Emilien-Wolff/Pronto-Abysse/README.md

# Pronto - projet de l'ingénieur dans un monde en transition ⚙️
> [!NOTE]
> Un projet dans le cadre de notre première année en école d'ingénieur visant la conception et fabrication complète d'un drone sous-marin radicommandé



## Objectifs

> Piloter le sous marin à distance et le contrôler (profondeur et déplacement) de manière précise et sans fils

> Transmettre une vidéo en direct à l'utilisateur. Nous prévoyons donc une bascule entre deux flux vidéo : l'un vers l'avant pour le pilotage et l'autre vers le fond pour l'observation

## Points abordés

 - Gestion de projet : diagramme de Gantt, partage des tâches et planification tout au long du projet
 - Invention et construction de A à Z une structure interne modulaire qui a montré son efficacité lors de
multiples assemblages et désassemblages lors des tests
 - Un dimensionnement global équilibré permettant le transport tout en embarquant l’ensemble de
l’électronique nécessaire à son maniement
 -  Des concepts inédits de dérive fonctionnels et pilotables par télécommande radio
 -  Une chaine de puissance sur mesure, correctement dimensionnée et également pilotable fi nement via la
télécommande
 -  Un asservissement fonctionnel de l’assiette, combiné à un controle de la fl ottabilité via des ballastsà
base de seringues
 -  Un prééquipement de fi xation pour les caméras, dirigées vers l’avant et vers le fond et une prévision
d’éclairage par leds puissantes à travers le tube transparent
 -  Une communication tout au long du projet

## FAQ

#### Vous avez pu choisir votre sujet ?
OUI, Pronto est une unité d'enseignement qui fait partie de la formation d'ingénieur à IMT Atlantique, et 3 sujet différents étaient possibles : le sujet ingénieur, le sujet recherche et finalement le sujet étudiant. C'est pour le dernier que nous avons opté. Nous avons donc pu choisir l'équipe et le sujet. En lien avec le contexte géographique de l'école, il nous semblait parfait.

#### Combien de temps ça vous a pris ?

Le projet a duré 5 mois, de janvier 2025 à  mi mai 2025

## 🚀 Qui sommes-nous ?
Nous sommes actuellement en première année d'école d'ingénieur à l'école des Mines IMT Atlantique.
