Emilien-Wolff/Pronto-Abysse/CAO/Readme.md

# Conception assistée par ordinateur

Ce dossier contient les fichiers de conception du sous-marin, réalisés avec Fusion 360.

## Contenu du dossier

- **Fichier `.f3z`** : Assemblages natifs de Fusion 360, permettant de modifier les composants individuellement. La conception est entièrement faite à la main, et des sections d'analyse (vue de coupe) sont intégrées au modèle

## Utilisation

- **Fusion 360** : Importez les fichiers `.f3z` pour modifier les composants du boîtier.

📁 *Assurez-vous d'extraire tous les fichiers associés avant d'ouvrir un assemblage dans Fusion 360.*
