Emilien-Wolff/Pronto-Abysse/STL à imprimer/Readme.md

# STL à imprimer

Ce dossier contient les fichiers STL des composants du sous-marin, réalisés avec Fusion 360 et entièrement dessinés à la main

## Contenu du dossier

- **Fichiers `.stl`** : pièces modélisées, qui peuvent s'ouvrir dans n'importe quel trancheur pour impression

📁 *Les impressions 3D ont toutes été faites en PLA, avec un remplissage variant en fonction de l'utilité des pièces. Les murs ont notamment été renforcés pour plus de durabilité.*

---

Impression 3D en PLA sur P1S, 0,2mm d'épaisseur de couche, avec supports, avec du filament bambulab mat
