Emilien-Wolff/Pronto-Abysse/Suivi de projet/Readme.md

# Suivi de projet

Voici un dossier qui contient les livrables des différents jalons projet

## Fichiers Inclus

- **83_cadrage_PRONTO_25.pdf :** Définissant notre besoin, notre analyse des solutions technique, le cahier des charges et la solution technique proposée
- **83_revue_PRONTO_25.pdf :** Présentation de l'avancée de mi projet en avril 2025

## Licence

Ce projet est libre d'accès
