Emilien-Wolff/Pronto-Abysse/83_recette_finale_PRONTO_25_compressed.pdf

### Recette - Projet Abysse

Tuteur : F. Le Pennec

Auteurs : E. Wolff (relecteur), A. Polette, P. Gonot, S. Khazari, G. Pauliat
Destinataires : F. Le Pennec, B. Abiven, M. Le Gall, J. Hemery

Groupe 83 Pronto
version 1.0
IMT Atlantique
23/05/25

SOMMAIRE
1. Présentation du projet et des objectifs
2. Conception
3. Réalisation et tests unitaires
4. Intégration et tests
5. Communication : site internet

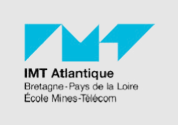
[picture p76: figure]

6. Perspectives d’amélioration
7. Travail de groupe

3
SOMMAIRE | 3
1. Présentation du projet et des objectifs
2. Conception
3. Réalisation et tests unitaires
4. Intégration et tests
5. Communication : site internet
6. Perspectives d’amélioration
7. Travail de groupe

Recette - Projet Abysse
Groupe 83 Pronto | 23/05/25

Présentation du projet et contextualisation | 4

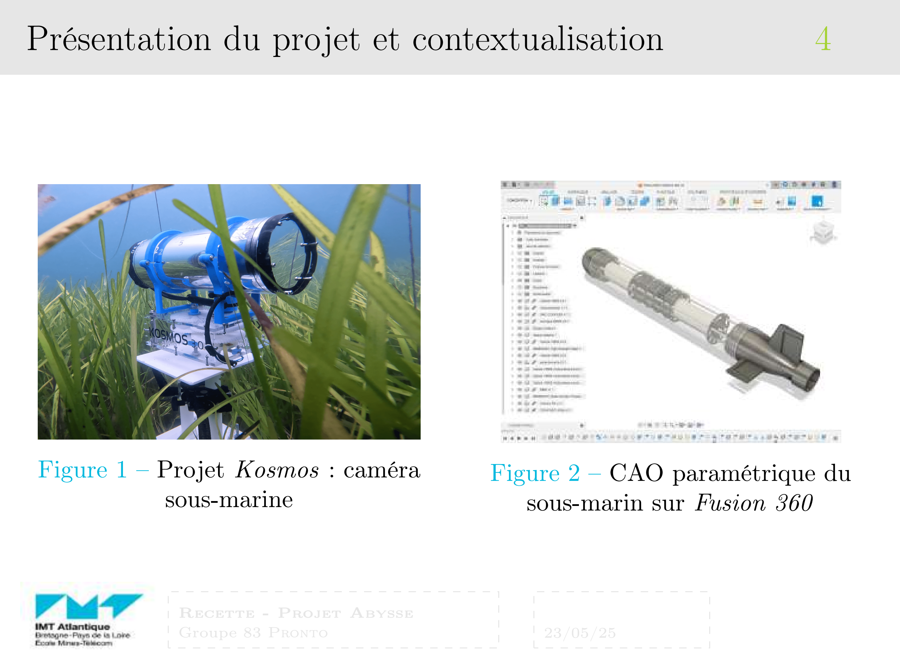
[picture p77: page 4]

4

Figure 1 – Projet Kosmos : caméra sous-marine

Figure 2 – CAO paramétrique du sous-marin sur Fusion 360

Recette - Projet Abysse

5
Présentation des objectifs | 5

Objectifs

1. Piloter le sous-marin à distance et le contrôler (profondeur et déplacement) de manière précise et sans fils
2. Transmettre une vidéo en direct à l’utilisateur. Nous prévoyons donc une bascule entre deux flux vidéo : l’un vers l’avant pour le pilotage et l’autre vers le fond pour l’observation

Recette - Projet Abysse

6
SOMMAIRE | 6
1. Présentation du projet et des objectifs
2. Conception
3. Réalisation et tests unitaires
4. Intégration et tests
5. Communication : site internet
6. Perspectives d’amélioration
7. Travail de groupe

Recette - Projet Abysse

7

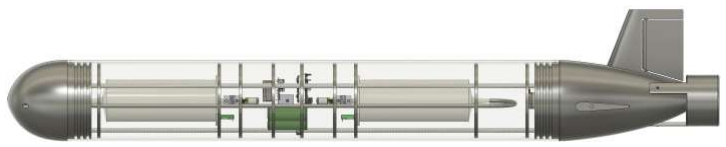
[picture p78: figure]

- Structure modulaire pour développement en parallèle
- Identification des fonctions internes

Recette - Projet Abysse

8
Présentation de la chaîne fonctionnelle | 8

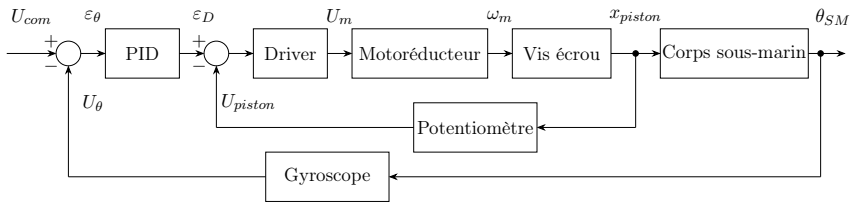
[picture p79: figure]
PID; Driver; Motoréducteur; Vis écrou; Corps sous-marin; Potentiomètre; Gyroscope; Ucom; xpiston; θSM; Upiston

Figure 3 – Schéma bloc de l’asservissement du sous-marin

Recette - Projet Abysse

9

### Dimensionnement général : taille du sous-marin 9

La masse envisageable pour être transportable serait donc d’environ 15 kg .

Limite de la flottabilité ⇒ poids équivalent à son rapport en eau, donc de volume
VSM = 15 · 10⁻³ m³

Notre idée initiale était de partir sur un tube de 128 mm, ce qui nous conduit à une longueur de

ℓSM =

VSM

Stube

=

VSM
πD²/4

=

15 · 10⁻³
π(128 · 10⁻³)
2/4
= | 1, 15 m | (1)

C’est utilisable

Recette - Projet Abysse

10
Dimensionnement général : structure interne | 10

Structure interne qui doit être solide et compartimentée ⇒ disques imprimés en 3D

- Perçages pour les batteries
- Inserts filetés pour fixer les composants
- Trous pour tiges filetées

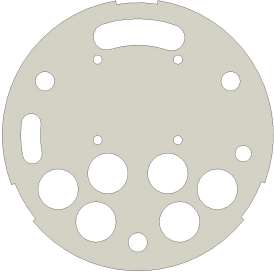
[picture p80: figure]

Figure 4 – Exemple de disque

Recette - Projet Abysse

11
Dimensionnement général : Choix du moteur | 11
Hélice : v = p × ω | (2)

Or choix du moteur selon le paramètre KV, avec p = 1.4 cm .

La vitesse d’avance étant de v = 5 km/h, soit 1, 4 m/s, nous en déduisons que le taux de rotation doit être de

ω =

1, 4
0, 014

= 100 tr/s = 6000 tr/min (3)

+25% ⇒ 7500 tr/min sous 12 V donc
7500/12 = 625 KV. On choisit un | 750 KV | .

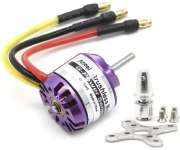
[picture p81: figure]

Figure 5 – Moteur
brushless choisi de
750KV

Recette - Projet Abysse

12
Conception assistée par ordinateur | 12

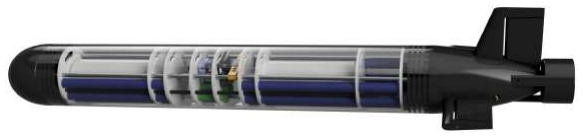
[picture p82: figure]

Figure 6 – Capture du modèle 3D du sous-marin fait sous Fusion 360 (Autodesk)

Pourquoi avoir modélisé en 3D ?

- Placement précis et simulation des liaisons
- Paramétrage → modèle qui se reconstruit
- Exportation pour Blender
- Production de plans 2D et modèles 3D pour tranchage et impression

Recette - Projet Abysse

13
Solution de direction | 13

Pour diriger le sous-marin, 2 solutions :
1. Implanter 4 pompes directrices
2. Utiliser des gouvernails comme dans les vrais sous-marins

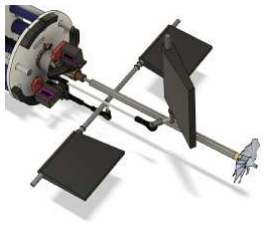
[picture p83: figure]
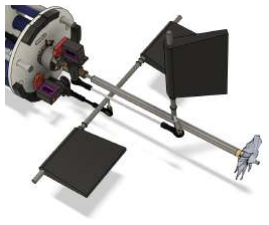
[picture p84: figure]

Figure 7 – Débattement mesurable sur CAO et permi par les servomoteurs

Recette - Projet Abysse

14
Lests et ballasts | 14

Par une étude statique, on récupère le nombre de barres N de lest nécessaires au sous-marin :

N =

(ρf luide · VSM − msans) · 4

ρferπD²L

(4)

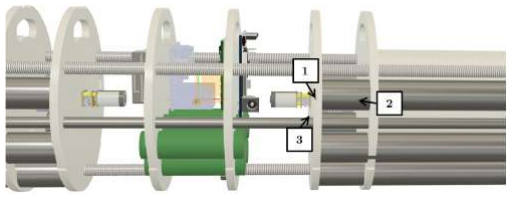
[picture p85: figure]

Figure 8 – Positions des centres de masse

Recette - Projet Abysse

15
Etanchéité | 15

Deux solutions d’étanchéité envisagées dans le projet :

- Des gorges dans l’impression 3D en (A) dans lesquelles se glissent des joints toriques
- Des plus petits joints toriques
en (B) dans lesquels

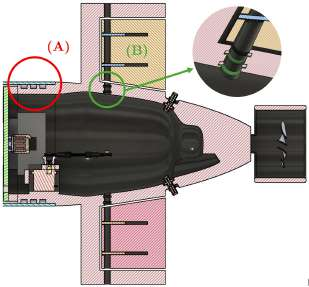
[picture p86: figure]

coulissent les axes | Figure 9 – Solutions de jointage
| dans la CAO

Recette - Projet Abysse

16
Mécanique de l’asservissement des ballasts | 16

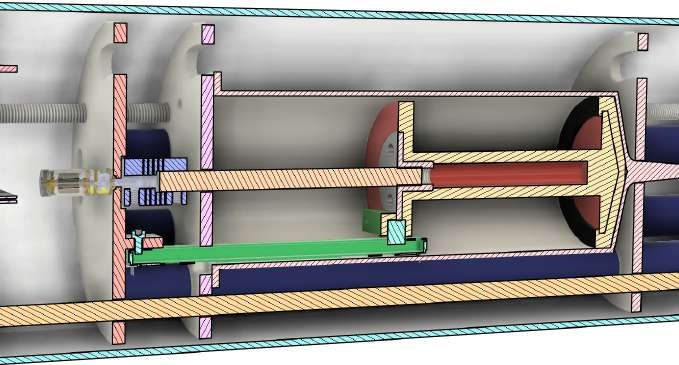
[picture p87: figure]

Figure 10 – Coupe de la partie seringue

Recette - Projet Abysse

17
Alimentation de l’électronique | 17

Figure 11 – Choix des cellules li-ion INR18650 3500 mAh

Dimensionnement de la batterie

- Évaluation du besoin
- tension nominale U ≈ 12 V
- intensité maximale Imax ≈ 16 A
- Réponse au besoin
- tension nominale Ucellule = 3, 7 V
- intensité maximale

Imax,cellule ≈ 10 A

⇒ batterie 3S2P

Recette - Projet Abysse

18
Alimentation de l’électronique | 18

Schéma électrique et choix des bandes conductrices

- Nécessité d’un BMS
- équilibrage des charges des
cellules
- protection de la batterie
- Choix du matériau et de la géométrie
- bandes de nickel
- 8 mm en largeur / 0.4 mm en épaisseur

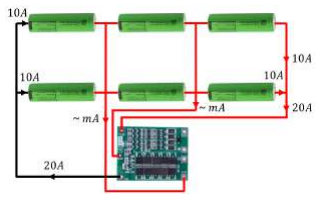
[picture p88: figure]

Figure 12 – Schéma électrique du lien batterie / BMS

Recette - Projet Abysse

Radiocommande | 19

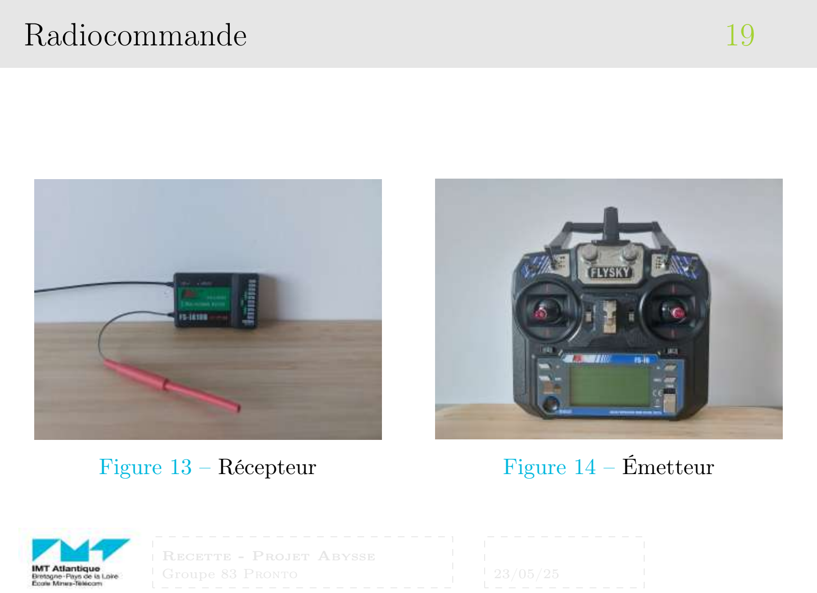
[picture p89: page 19]

19

Figure 13 – Récepteur | Figure 14 – Émetteur

Recette - Projet Abysse

Circuits électriques indépendants | 20

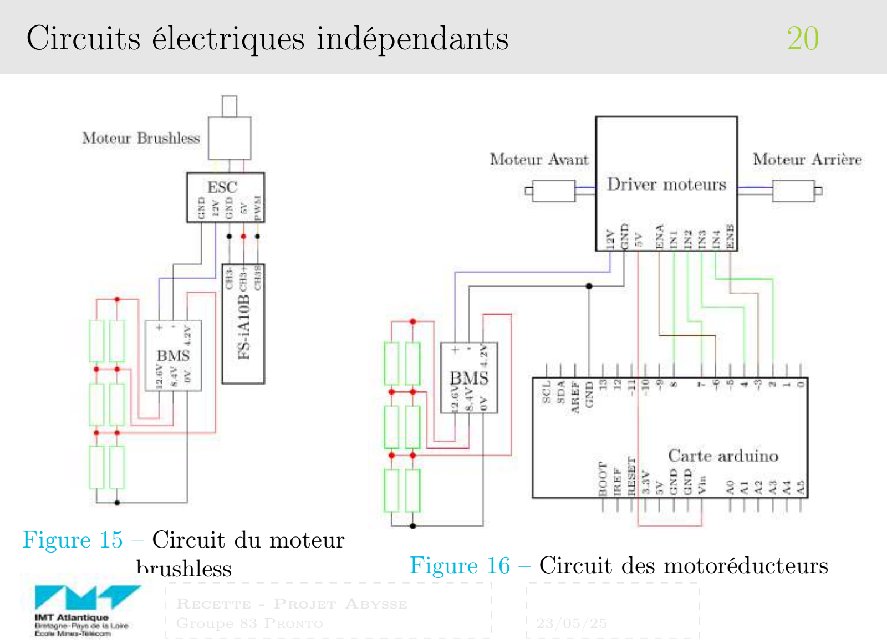
[picture p90: page 20]

20

Figure 15 – Circuit du moteur
brushless | Figure 16 – Circuit des motoréducteurs

Recette - Projet Abysse

21

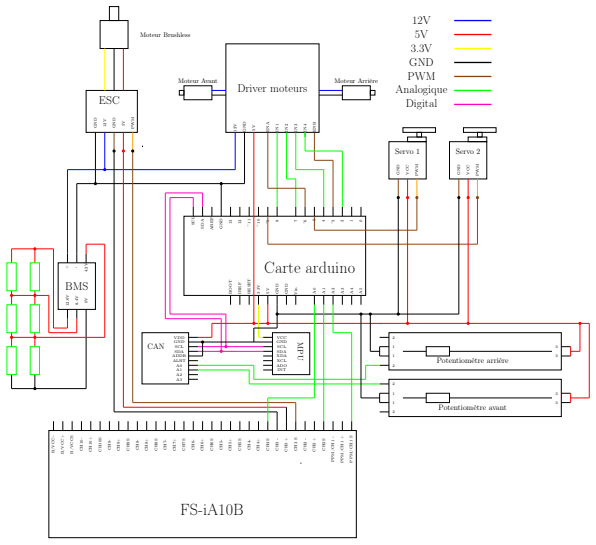
[picture p91: figure]
Driver moteurs; SDA; AREF; GND; SCL; BOOT; IREF; RESET; Vin; ENA; ENB; PPM/CH1 S; PPM/CH1 -; PPM/CH1 +; Servo 1 GND; VCC; Servo 2 GND; PWM; VCC GND; SCL SDA XDA XCL ADO; INT; MPU; Moteur Avant; Moteur Arrière; 12V 5V 3.3V GND; PWM Analogique Digital; 8.4V BMS; Carte arduino CH¹⁰⁻; CH⁹⁻; CH⁹+; CH⁹S; CH⁸⁻; CH⁸+; CH⁸S; CH⁷⁻; CH⁷+; CH⁷S; CH⁶⁻; CH⁶+; CH⁶S; B/VCC-; B/VCC+; B/VCCS; VDD CAN GND SCL SDA ADDR ALRT A0 A1 A2 A3; 3 3 Potentiomètre arrière; 3 3 Potentiomètre avant; Moteur Brushless; ESC

Figure 17 – Circuit électrique complet du sous-marin

Recette - Projet Abysse

22
Structure du code | 22

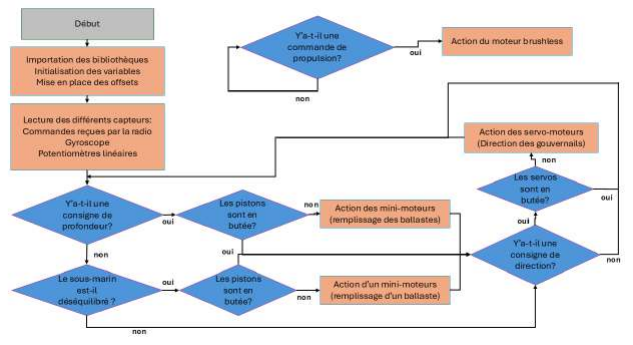
[picture p92: figure]

Figure 18 – Structure du code

Recette - Projet Abysse

23
SOMMAIRE | 23
1. Présentation du projet et des objectifs
2. Conception
3. Réalisation et tests unitaires
4. Intégration et tests
5. Communication : site internet
6. Perspectives d’amélioration
7. Travail de groupe

Recette - Projet Abysse

24
Indépendance des opérations | 24

L’avancée du projet a été permise par la parallélisation des tâches, grâce aux modules du projet :

Montage du sous-marin avec composants | Usinage des pièces mécaniques
CAO complète | Création des circuits électroniques
Phase de cadrage | Commande des pièces

Programmation de l’Arduino et adaptations

Transmission vidéo et RC

t

P1

P2

P2

P2

P2

Figure 19 – Étagement du projet

Recette - Projet Abysse

25
Impression et implantation des disques | 25

Disques imprimés et leur montage :

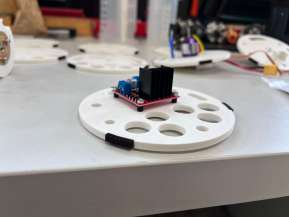
[picture p93: figure]
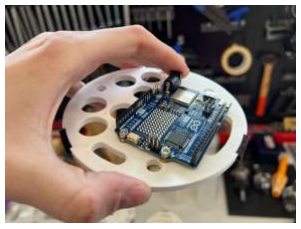
[picture p94: figure]

Figure 20 – Exemple de certains disques (à gauche, celui supportant le contrôleur moteur, éloigné de la surface par des entretoises elles aussi imprimées et à droite, celui tenant l’Arduino)

Recette - Projet Abysse

26
Impression et implantation des ogives | 26

Structure :

- Esthétique : corps
transparent
- Limiter les problèmes
d’étanchéité : augmentation les risques avec le nombre de jonctions

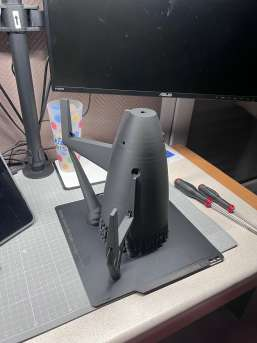
[picture p95: figure]

Figure 21 – Ogive arrière, sortie d’imprimante

Recette - Projet Abysse

27
Réalisation de la batterie | 27

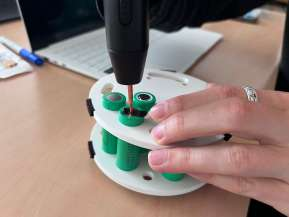
[picture p96: figure]
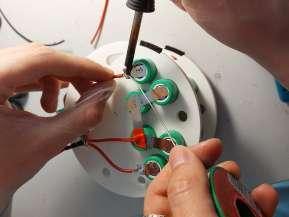
[picture p97: figure]

Figure 22 – Deux techniques de soudage : soudage par point à gauche, soudage classique à droite

Recette - Projet Abysse

Réalisation de la batterie | 28

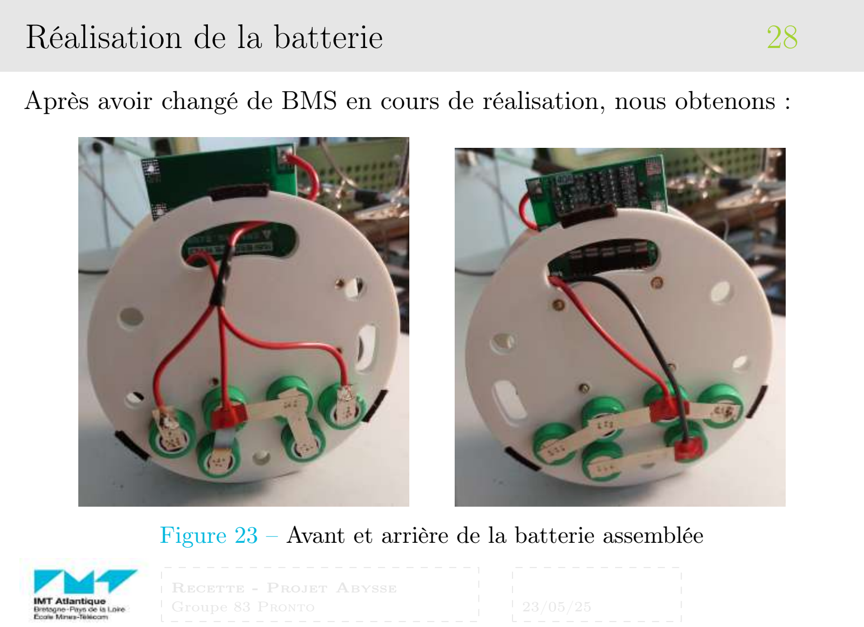
[picture p98: page 28]

28

Après avoir changé de BMS en cours de réalisation, nous obtenons :

Figure 23 – Avant et arrière de la batterie assemblée

Recette - Projet Abysse

29
Usinage des axes | 29

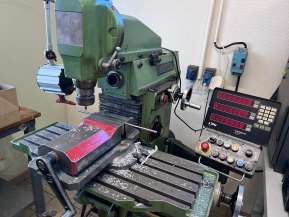
[picture p99: figure]
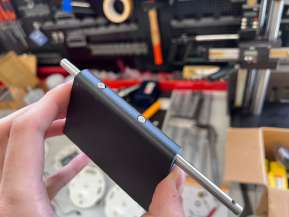
[picture p100: figure]

Figure 24 – Usinage sur fraiseuse des axes et montage sur les gouvernails

Recette - Projet Abysse

30
Tiges de commande | 30

Sont présents :
- les supports des servomoteurs,
intégrés dans la coque intérieur de l’impression 3D et qui
reçoivent des inserts filetés pour y visser une plaque pour empêcher leur mouvement
lorsque l’index tourne
- un des axes qui apparaît horizontalement
- la biellette excentrée qui est actionnée par les servomoteurs démontés pour la photo.

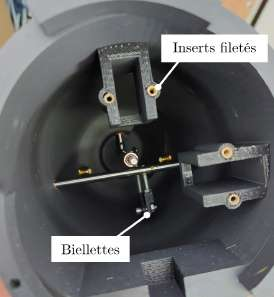
[picture p101: figure]

Figure 25 – Tringlerie de l’ogive arrière

Recette - Projet Abysse

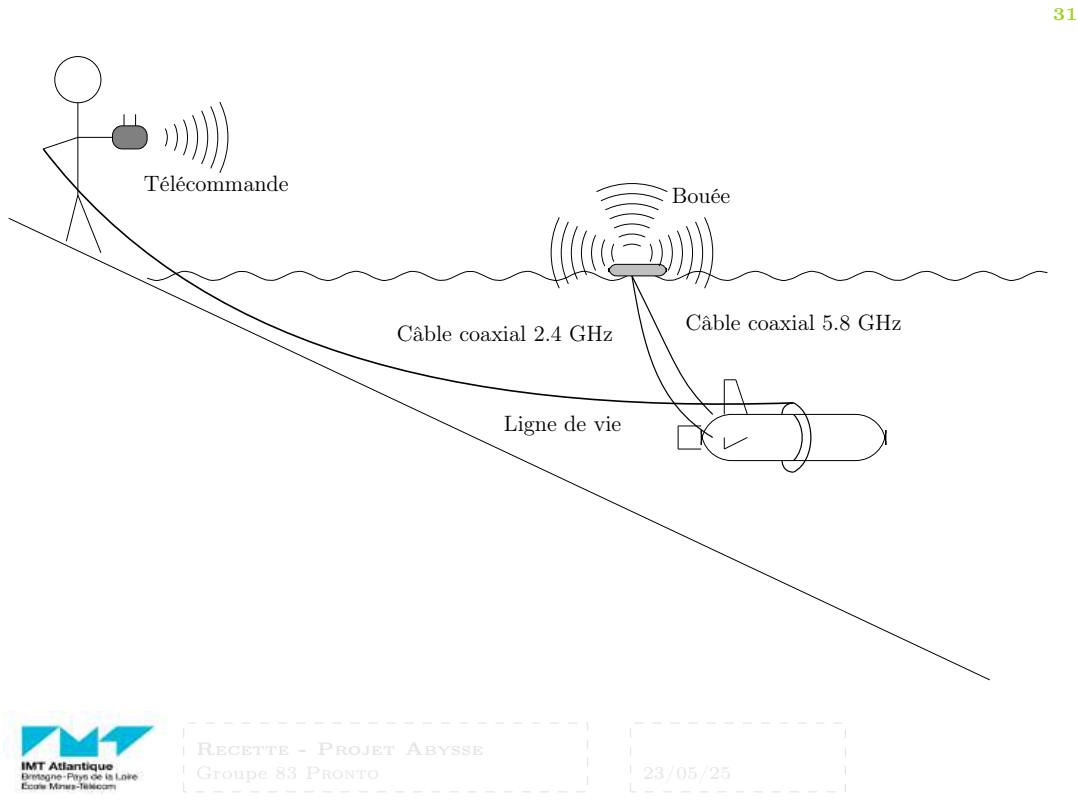
[picture p102: page 31]
Télécommande; Bouée

Câble coaxial 5.8 GHz Câble coaxial 2.4 GHz

Ligne de vie

Recette - Projet Abysse

32
Tests communication | 32

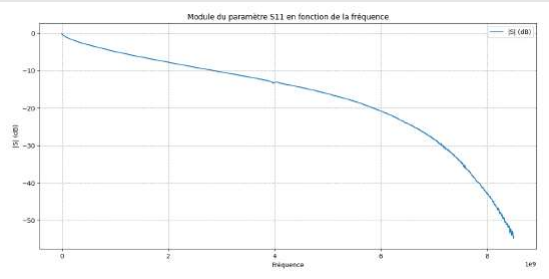
[picture p103: figure]

Figure 26 – Paramètre s12 du câble

Recherche de la meilleure transmission de puissance possible
- Très bonne pour les fonctions de commande
- Moins pour la vidéo

Recette - Projet Abysse

33
Tests communication | 33

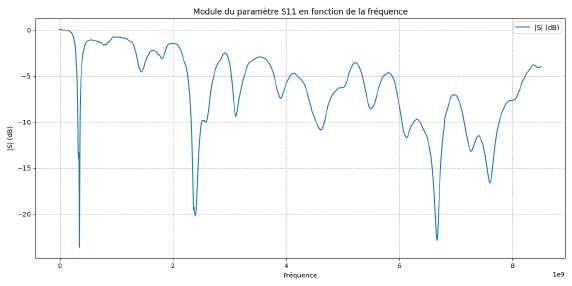
[picture p104: figure]

Figure 27 – Paramètre s11 de l’antenne

- Adaptée au 2.4GHz

Recette - Projet Abysse

34
SOMMAIRE | 34
1. Présentation du projet et des objectifs
2. Conception
3. Réalisation et tests unitaires
4. Intégration et tests
5. Communication : site internet
6. Perspectives d’amélioration
7. Travail de groupe

Recette - Projet Abysse

35
Environnement de travail | 35

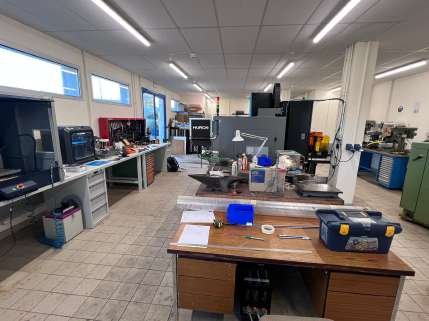
[picture p105: figure]

Figure 28 – Table de montage dans l’atelier mécanique de IMT Atlantique et machine d’usinage

Recette - Projet Abysse

36
Méthodologie de montage | 36

Les étapes de montage du
sous-marin ont été les suivantes :
- Essai dimensionnel de la solution à joints toriques
- Montage unitaire des
composants sur les disques
- Coulissage des disques sur les tiges filetées en respectant les espacements
- Insertion dans le tube et fermeture de l’ensemble

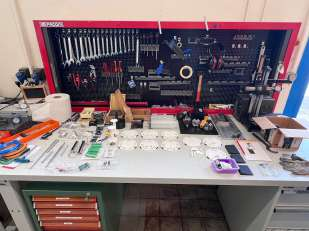
[picture p106: figure]

Figure 29 – Rangement des
composants

Recette - Projet Abysse

### Tests d’étanchéité de l’ensemble : test en piscine 37

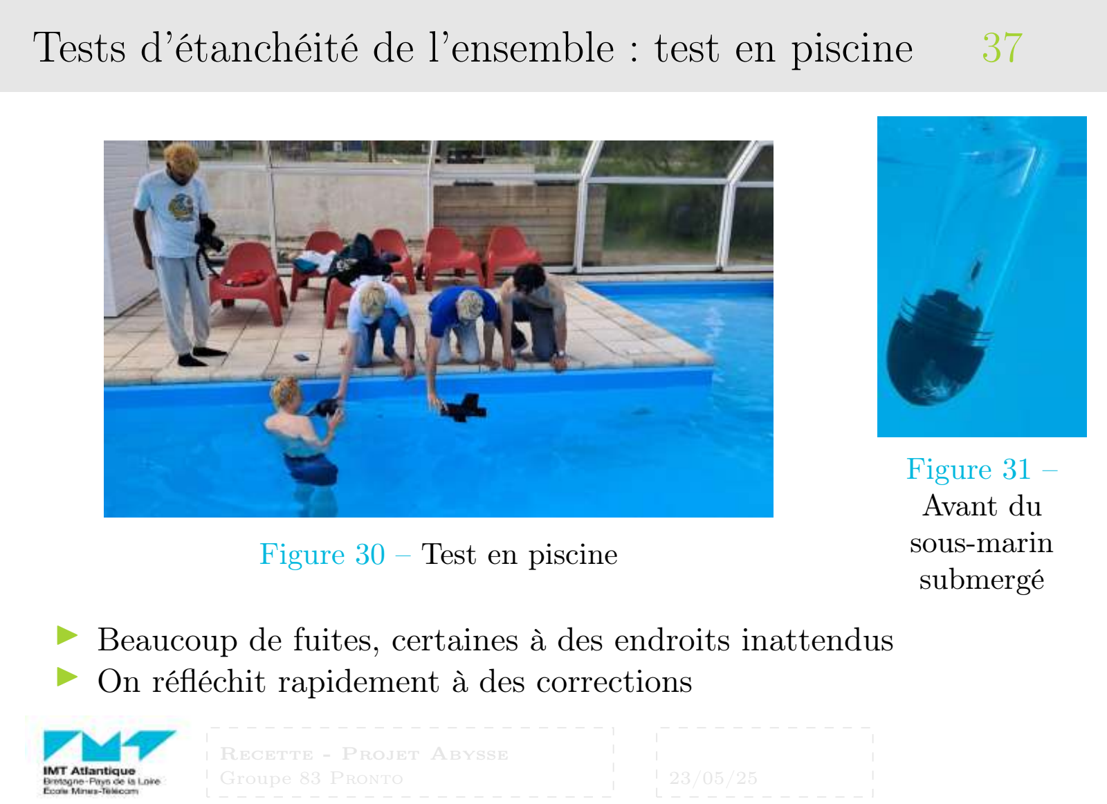
[picture p107: page 37]

37

Figure 30 – Test en piscine

Figure 31 –
Avant du
sous-marin
submergé
- Beaucoup de fuites, certaines à des endroits inattendus
- On réfléchit rapidement à des corrections

Recette - Projet Abysse

Tests d’étanchéité de l’ensemble : test en bac | 38

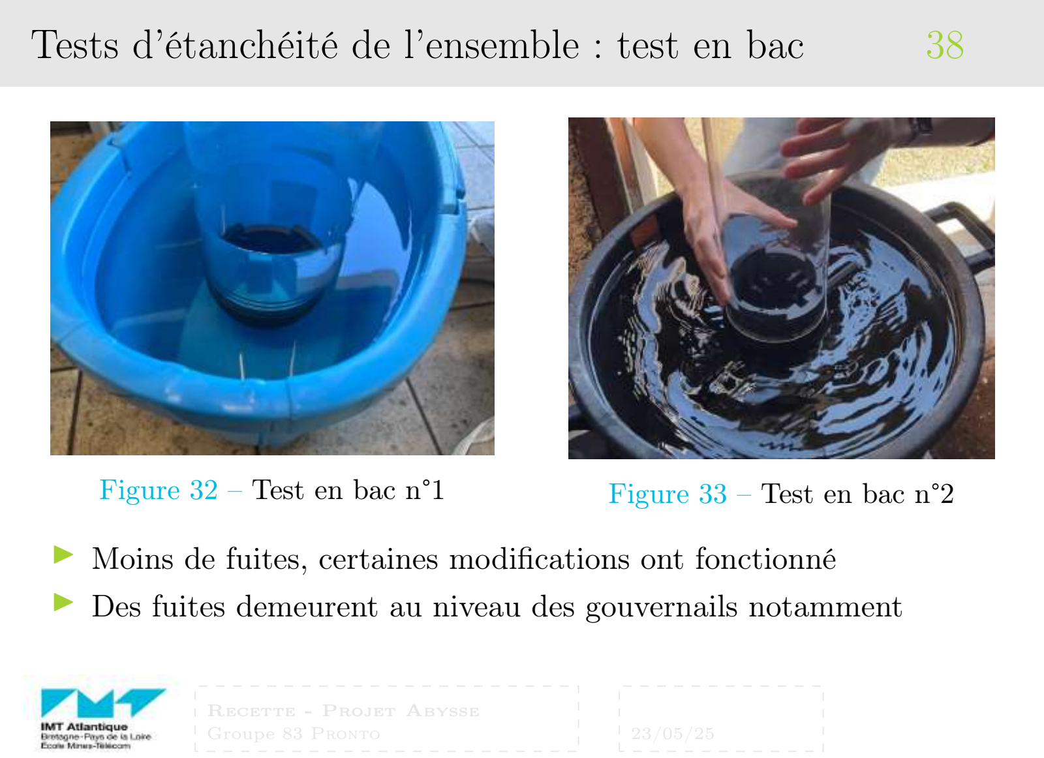
[picture p108: page 38]

38

Figure 32 – Test en bac n°1 | Figure 33 – Test en bac n°2
- Moins de fuites, certaines modifications ont fonctionné
- Des fuites demeurent au niveau des gouvernails notamment

Recette - Projet Abysse

39
Remplissage des ballasts | 39

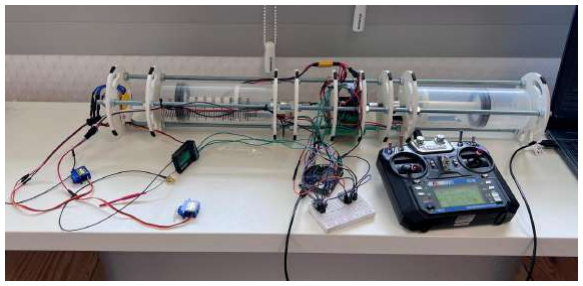
[picture p109: figure]

Figure 34 – Module électronique

- Les deux pistons ne progressent pas à la même vitesse
- Difficulté du côté du piston avant

Recette - Projet Abysse

40
Adaptation du code à la réalité pratique | 40

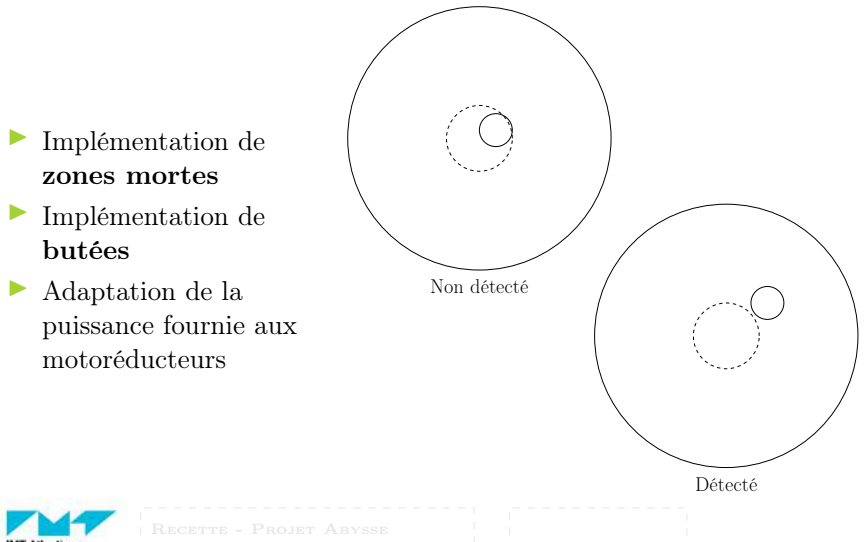
[picture p110: figure]
▶ Implémentation de; zones mortes ▶ Implémentation de; butées ▶ Adaptation de la; puissance fournie aux motoréducteurs; Non détecté; Détecté; Recette - Projet Abysse

41
SOMMAIRE | 41
1. Présentation du projet et des objectifs
2. Conception
3. Réalisation et tests unitaires
4. Intégration et tests
5. Communication : site internet
6. Perspectives d’amélioration
7. Travail de groupe

Recette - Projet Abysse

42
Réalisation de notre site internet | 42

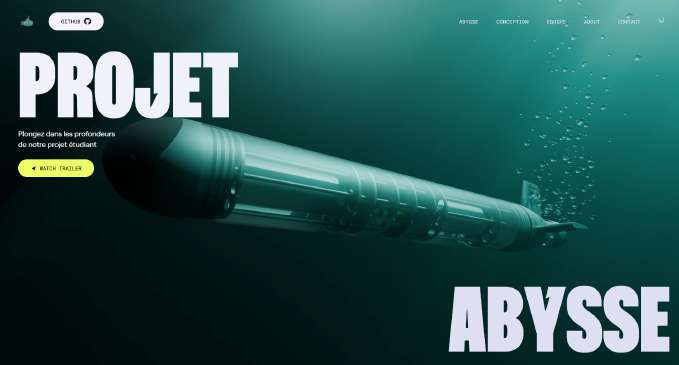
[picture p111: figure]

Figure 35 – Capture d’écran du site web

Recette - Projet Abysse

43
Architecture et immersion | 43

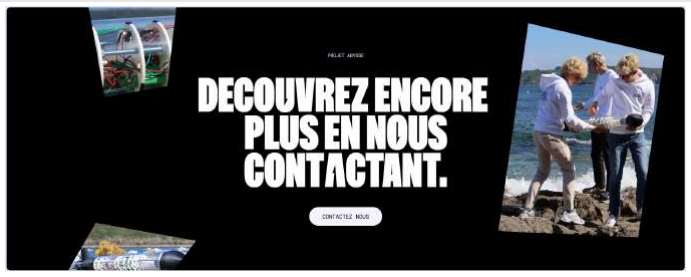
[picture p112: figure]

Figure 36 – Un site pensé comme une expérience

- Site one-page dynamique avec scroll fluide
- Nombreuses animations visuelles au fil du scroll
- Ambiance sonore : bruit marin et sonar discret

Recette - Projet Abysse

44
Pourquoi React ? | 44

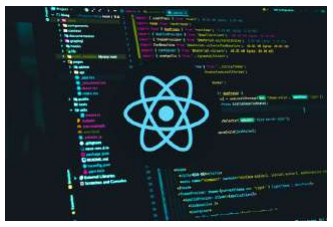
[picture p113: figure]

Figure 37 – React

- Options envisagées :
- HTML/CSS
- CMS comme WordPress
- React choisi : composants réutilisables, animations faciles à intégrer, grande liberté de création
- Stack : React + Tailwind CSS + GSAP

Recette - Projet Abysse

45
Contenus et éléments clés | 45

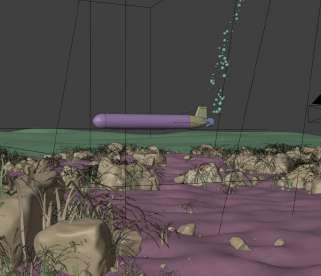
[picture p114: figure]

Figure 38 – Importation de Fusion 360 dans la modélisation Blender

- Présentation de l’équipe et du sous-marin
- Modèle 3D interactif du
prototype
- Galerie photo
- Lien vers notre GitHub
- Illustrations réalistes avec scènes animées via Blender

Recette - Projet Abysse

46
Mise en ligne et rôle du site | 46

Figure 39 – Déploiement sur Netlify grâce à Github

- Hébergement via Netlify avec déploiement automatique depuis GitHub
- Site toujours à jour, accessible à tous
- Outil de communication moderne qui valorise à la fois le fond technique et la forme immersive

Recette - Projet Abysse

47
SOMMAIRE | 47
1. Présentation du projet et des objectifs
2. Conception
3. Réalisation et tests unitaires
4. Intégration et tests
5. Communication : site internet
6. Perspectives d’amélioration
7. Travail de groupe

Recette - Projet Abysse

48
Intégrations supplémentaires | 48
- Implémentation des caméras
- Étanchéification des ogives
- Choix de métaux inoxydables
- Mise en place de la bouée

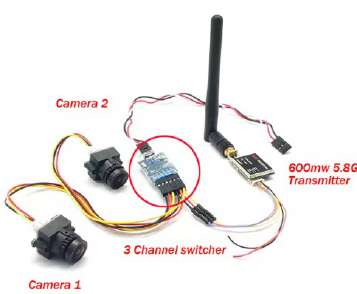
[picture p115: figure]

Figure 40 – Kit caméra

Recette - Projet Abysse

49
Améliorations possibles du code | 49
- Rendre le comportement des servomoteurs plus fluide
- Moduler les deux pistons en même temps au lieu d’un pour l’équilibrage
- Améliorer la précision des différents paramètres de manière empirique

Recette - Projet Abysse

50
SOMMAIRE | 50
1. Présentation du projet et des objectifs
2. Conception
3. Réalisation et tests unitaires
4. Intégration et tests
5. Communication : site internet
6. Perspectives d’amélioration
7. Travail de groupe

Recette - Projet Abysse

51
Retour d’expérience sur la gestion de projet | 51

Réussites de la gestion de projet :

- Planification à l’aide de Ganttproject
- Réduction des problèmes de conception en amont avec la CAO 3D
- Organisation pour la gestion des problèmes : solutions
alternatives, tests, etc.

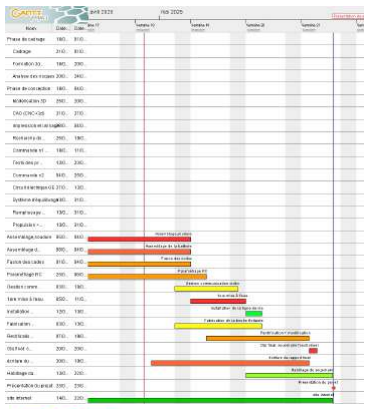
[picture p116: figure]

Recette - Projet Abysse

52
Retour d’expérience sur l’organisation | 52

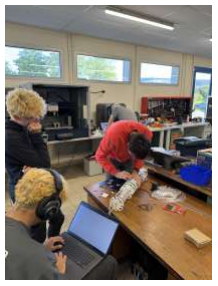
[picture p117: figure]

Figure 41 – L’équipe qui travaille à l’atelier

Réussites de l’organisation :

- Parallélisation des taches
- Organisation des séances
- Outils collaboratifs
- Collaboration avec des
personnes extérieures à
l’équipe Pronto

Recette - Projet Abysse

53
Bilan | 53

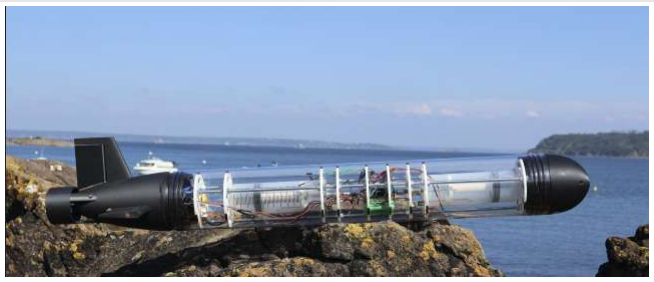
[picture p118: figure]

✓ Construire de A à Z un sous-marin
✓ Chaîne de puissance sur mesure
✓ Asservissement de ballast fonctionnel ✓ Communication tout au long du projet

Recette - Projet Abysse

54
Conclusion | 54

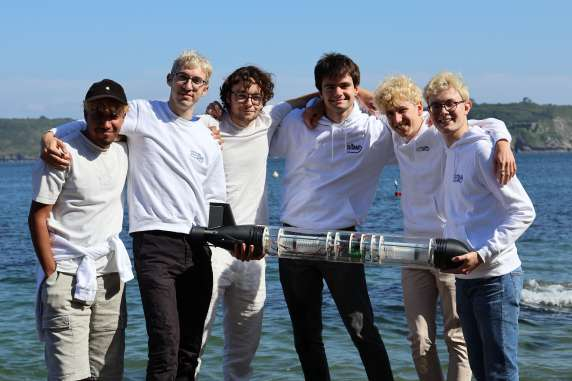
[picture p119: figure]

Figure 42 – La Pron’team et son sous-marin

Recette - Projet Abysse

55
1 - Références du projet | 55
[1] Brick experiment Channel, Building a Lego-powered Submarine 4.0 - automatic depth control, Youtube, 16 juil. 2022. https://www.youtube.com/watch?v=KLEH8RJsYgI
[2] Antoine Géju, Projet Kosmos, 2025. https://kosmos.fish/index.php/faq/
[3] Saad-Eddine Khazari, Site Web du projet Abysse, 2025. https://abysse.netlify.app/
[4] Diy Perks, Building a DIY submarine - DIY Perk, 2025. https://www.youtube.com/watch?v=pUba126uzvU
[5] Norelem, Informations techniques pour le joint torique, 2025. https://urlr.me/eW8s36

Recette - Projet Abysse

56
2 - Utilisation d’inserts filetés | 56

Pour assurer le bon maintien des composants, on a utilisé des inserts filetés

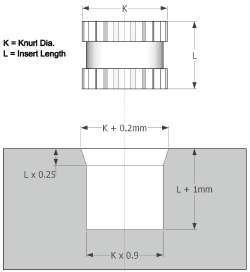
[picture p120: figure]

Figure 43 – Préconisation de modélisation

Utilisation du PLA (polylactic acid) :

- Facilité d’impression : faible retrait thermique, bonne
adhérence au plateau
- Écologique et biodégradable : fabriqué à partir d’amidon de maïs ou de canne à sucre
- Étanche (testé en conditions extrêmes)

Recette - Projet Abysse

57
3 - Ampacity of metal strips | 57

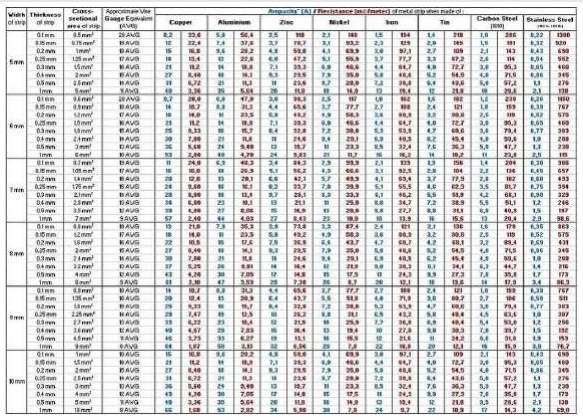
[picture p121: figure]

Recette - Projet Abysse

58
4 - Code | 58

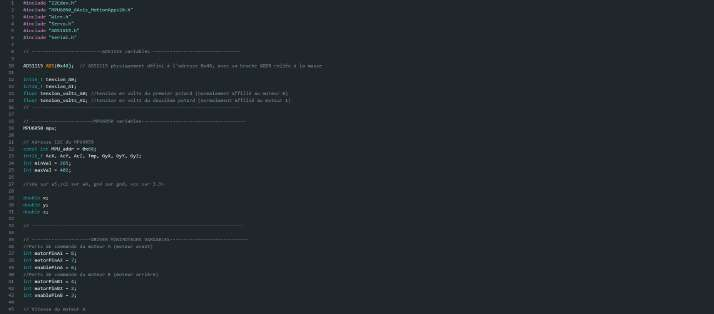
[picture p122: figure]

Recette - Projet Abysse

59

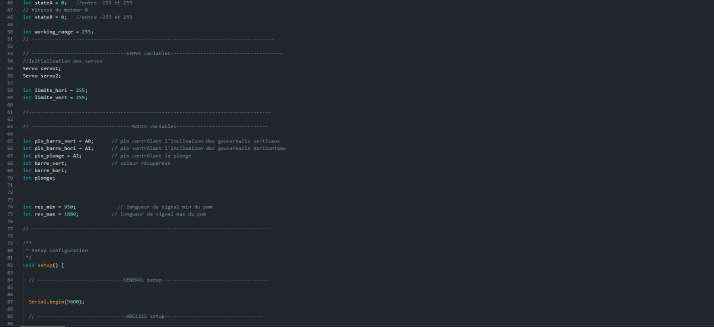
[picture p123: figure]

Recette - Projet Abysse

60

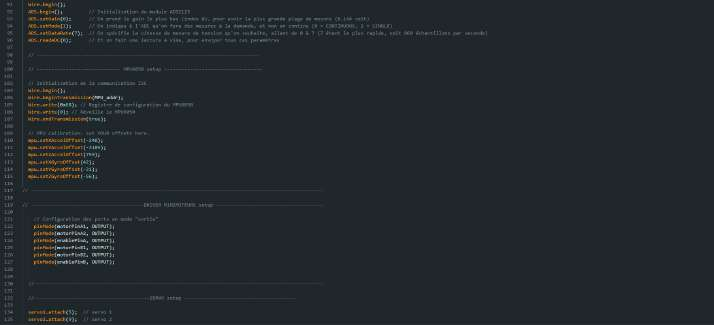
[picture p124: figure]

Recette - Projet Abysse

61

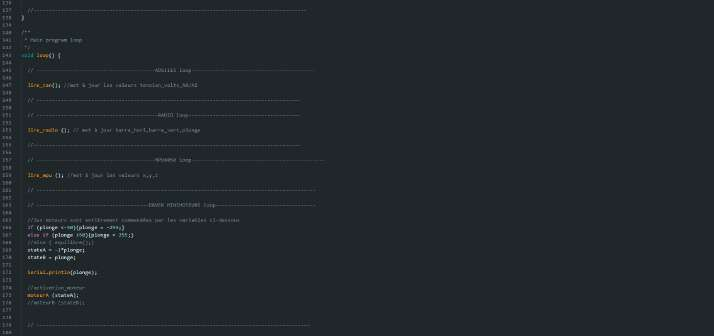
[picture p125: figure]

Recette - Projet Abysse

62

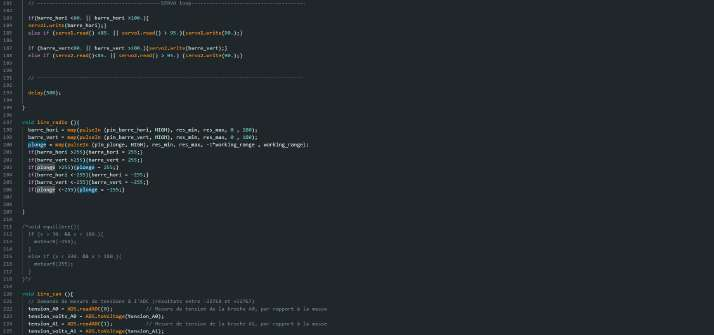
[picture p126: figure]

Recette - Projet Abysse

63

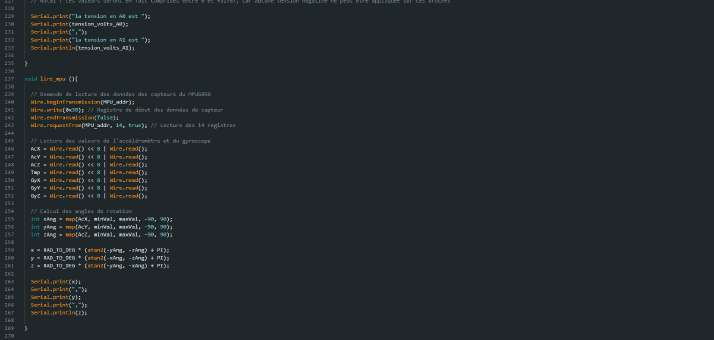
[picture p127: figure]

Recette - Projet Abysse

64

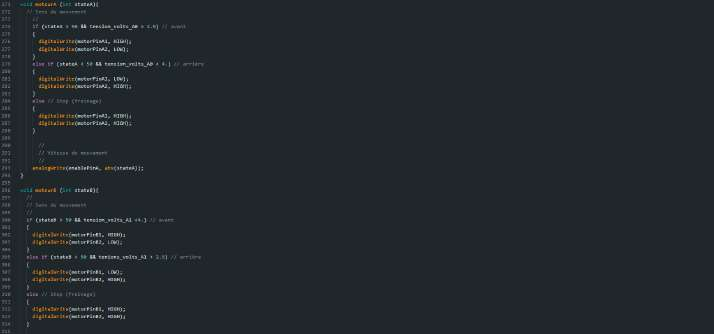
[picture p128: figure]

Recette - Projet Abysse

65

Recette - Projet Abysse
