Emilien-Wolff/Pronto-Abysse/STL à imprimer/Piston.stl

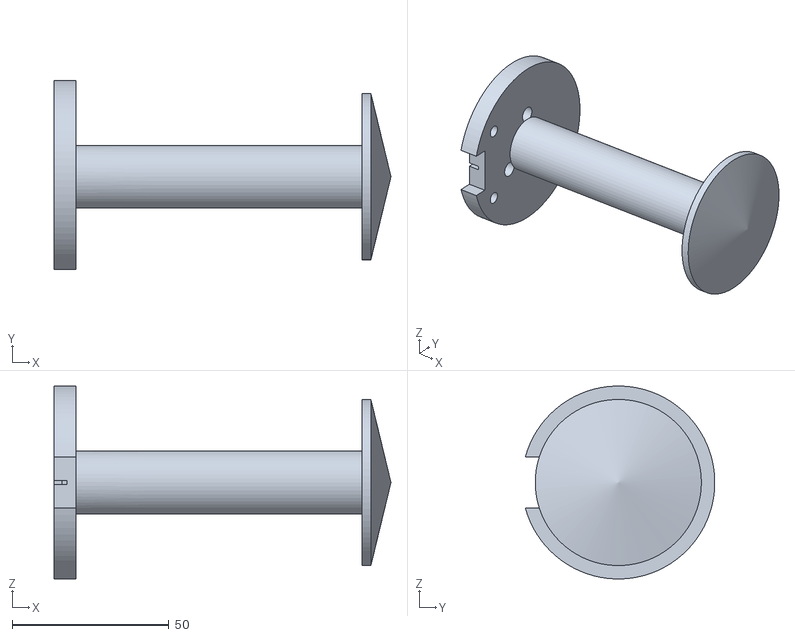
[picture p137: CAD file, 2025-05-24]
STL à imprimer/Piston.stl
107.5 x 60.4 x 61.5
