Emilien-Wolff/Pronto-Abysse/STL à imprimer/VoletHG.stl

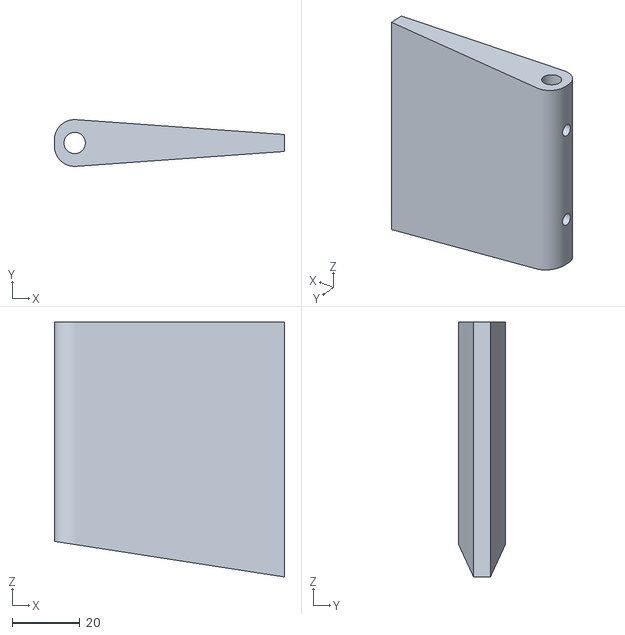
[picture p138: CAD file, 2025-05-24]
STL à imprimer/VoletHG.stl
68.0 x 13.8 x 75.3
