Emilien-Wolff/Pronto-Abysse/STL à imprimer/FixationServoDeriveH.stl

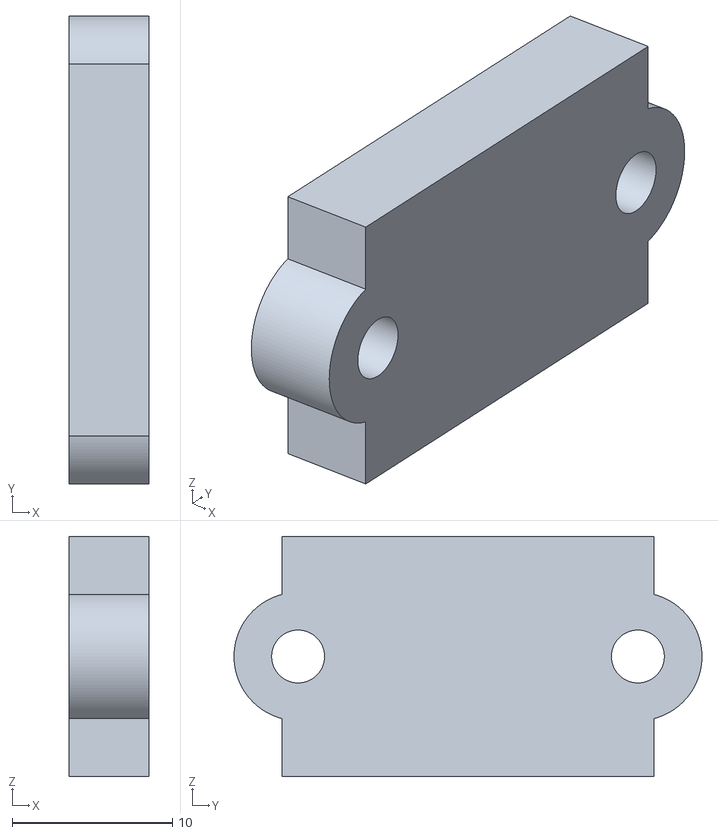
[picture p139: CAD file, 2025-05-24]
STL à imprimer/FixationServoDeriveH.stl
5.00 x 29.2 x 15.0
