Emilien-Wolff/Pronto-Abysse/STL à imprimer/Ogive.stl

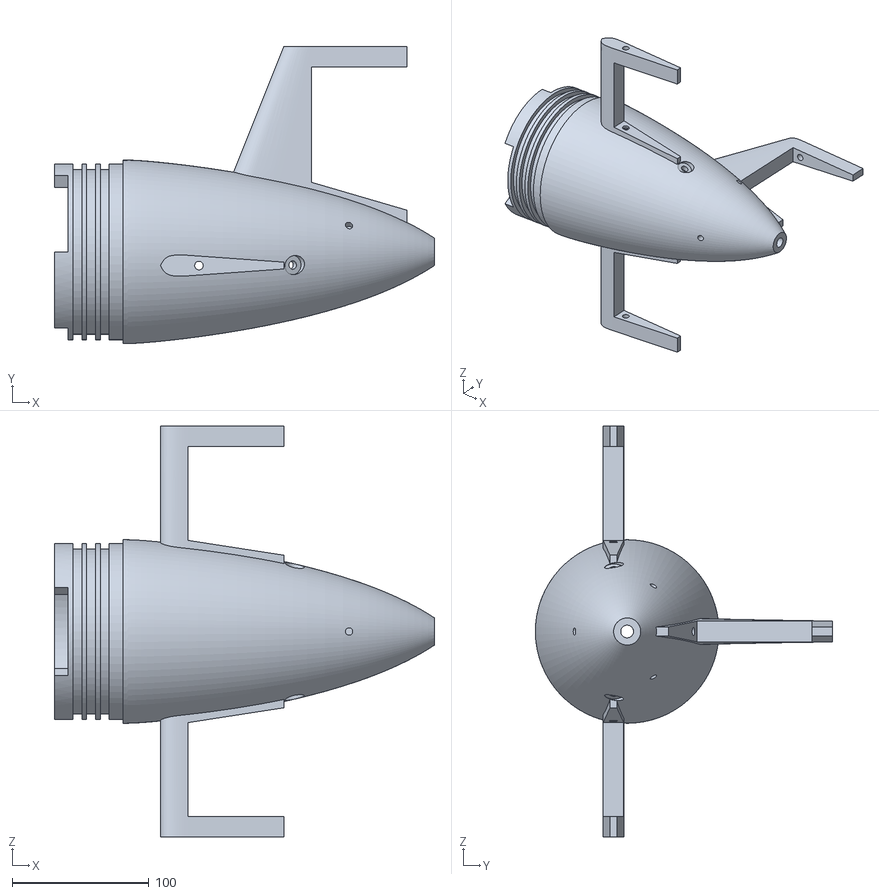
[picture p140: CAD file, 2025-05-24]
STL à imprimer/Ogive.stl
277.5 x 217.0 x 300.0
