Emilien-Wolff/Pronto-Abysse/STL à imprimer/bride ESC.stl

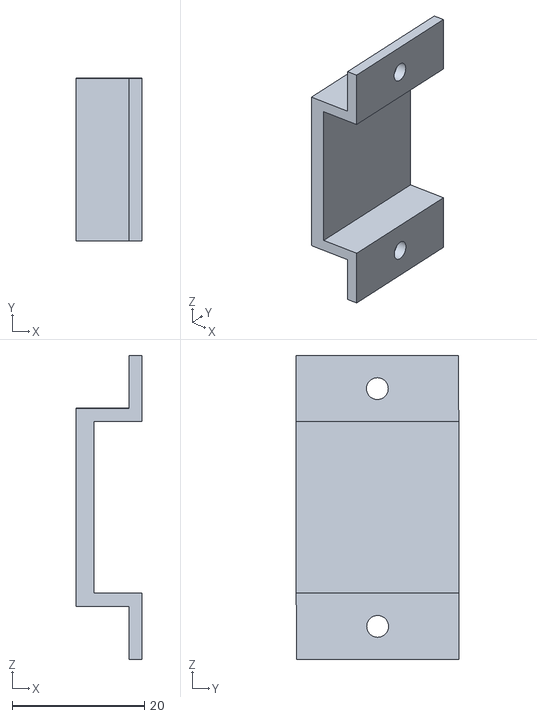
[picture p141: CAD file, 2025-05-24]
STL à imprimer/bride ESC.stl
10.0 x 24.7 x 46.0
