Emilien-Wolff/Pronto-Abysse/STL à imprimer/Disque_seringue_pointe_AR.stl

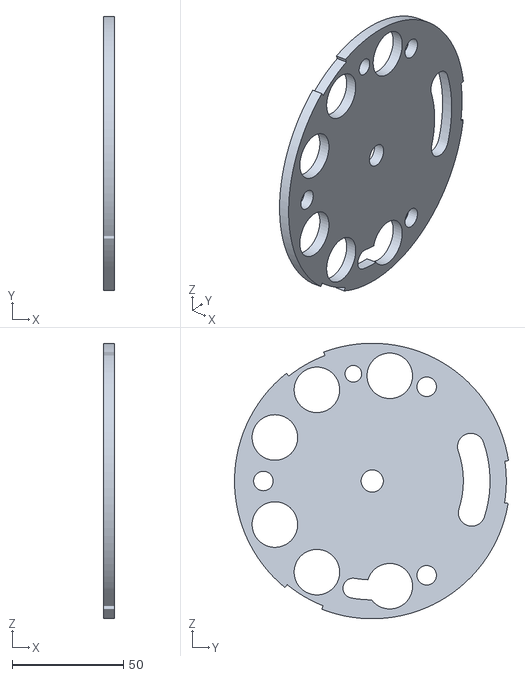
[picture p142: CAD file, 2025-05-24]
STL à imprimer/Disque_seringue_pointe_AR.stl
5.00 x 123.3 x 124.0
