Emilien-Wolff/Pronto-Abysse/STL à imprimer/support bms.stl

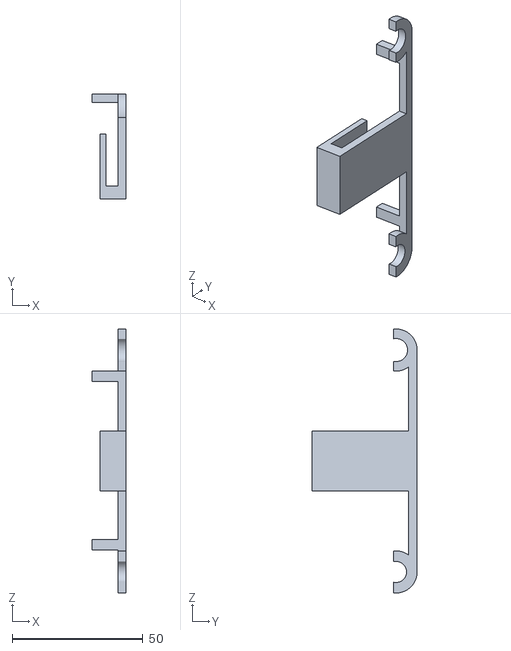
[picture p143: CAD file, 2025-05-24]
STL à imprimer/support bms.stl
13.0 x 40.3 x 101.0
