Emilien-Wolff/Pronto-Abysse/STL à imprimer/Coiffe.stl

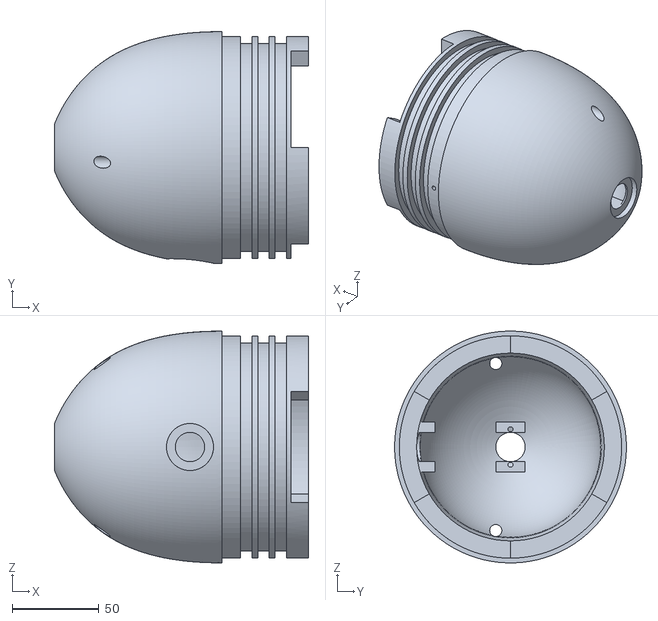
[picture p144: CAD file, 2025-05-24]
STL à imprimer/Coiffe.stl
146.8 x 134.0 x 133.9
