Emilien-Wolff/Pronto-Abysse/STL à imprimer/Disque moteur(Symétrie miroir).step

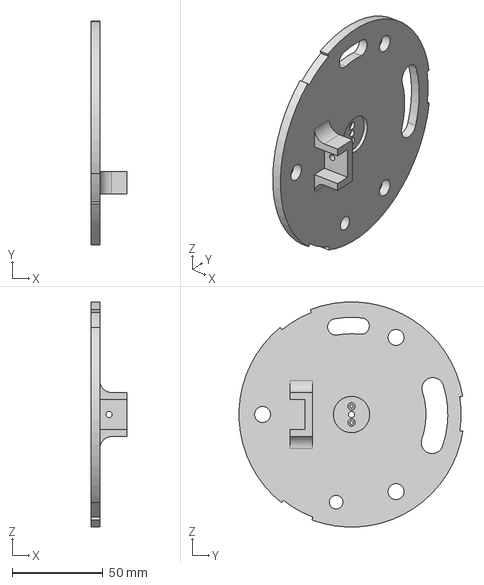
[picture p145: CAD file, 2025-05-24]
STL à imprimer/Disque moteur(Symétrie miroir).step
20.0 x 123.3 x 123.9 mm
