Emilien-Wolff/Pronto-Abysse/STL à imprimer/DeriveVmobile.stl

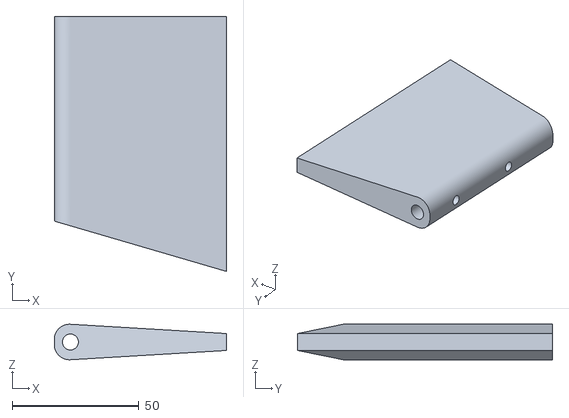
[picture p146: CAD file, 2025-05-24]
STL à imprimer/DeriveVmobile.stl
68.0 x 100.6 x 14.0
