Emilien-Wolff/Pronto-Abysse/STL à imprimer/carter hélice.stl

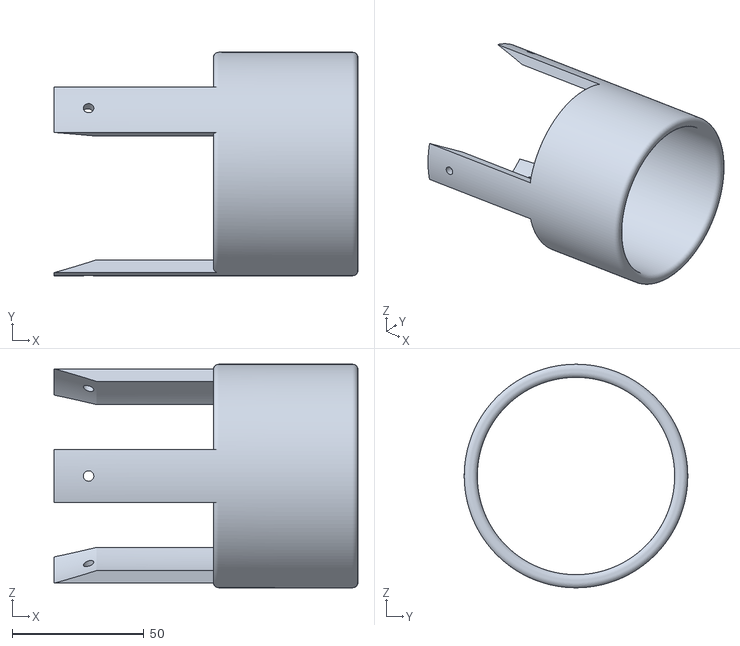
[picture p147: CAD file, 2025-05-24]
STL à imprimer/carter hélice.stl
115.6 x 85.0 x 85.0
