Emilien-Wolff/Pronto-Abysse/STL à imprimer/BridePotar.stl

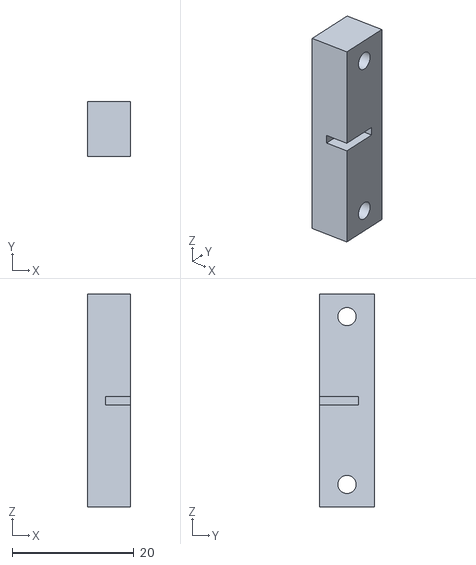
[picture p148: CAD file, 2025-05-24]
STL à imprimer/BridePotar.stl
7.00 x 9.05 x 35.0
