Emilien-Wolff/Pronto-Abysse/STL à imprimer/SupportAccelerometre.stl

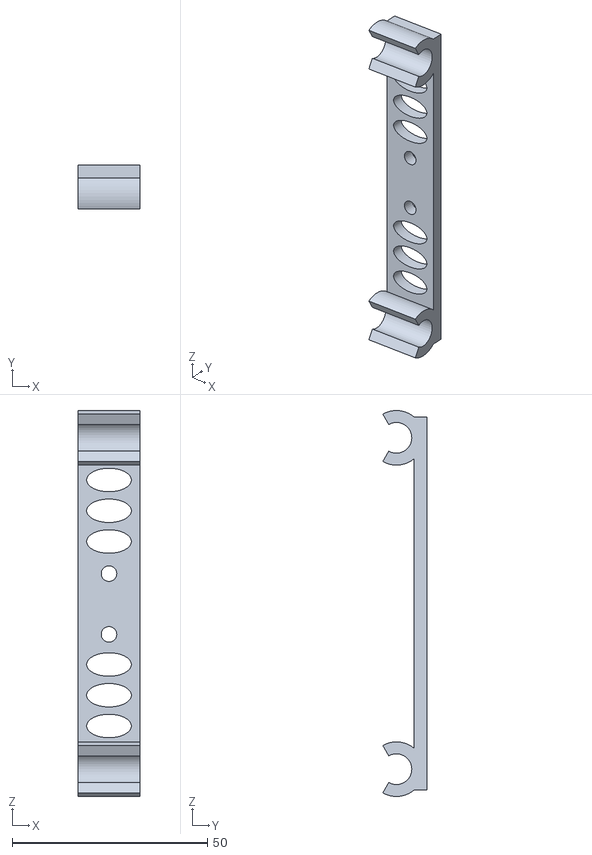
[picture p149: CAD file, 2025-05-24]
STL à imprimer/SupportAccelerometre.stl
16.0 x 11.4 x 98.9
