Emilien-Wolff/Pronto-Abysse/STL à imprimer/Disque_moteur_propulsion.stl

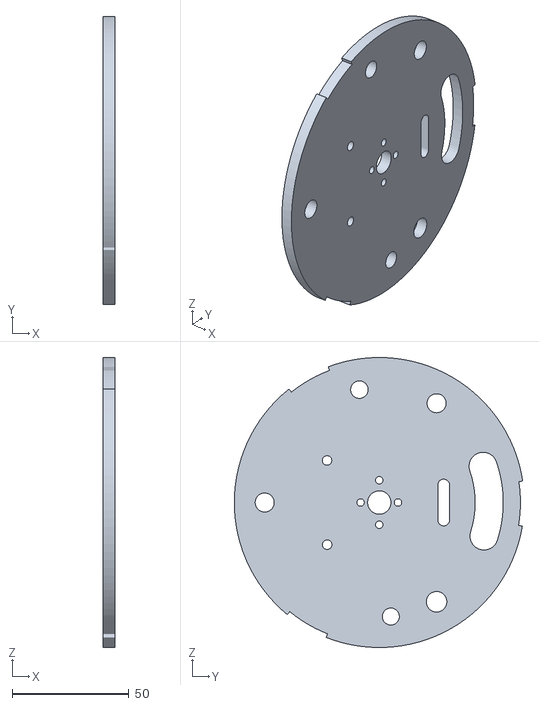
[picture p150: CAD file, 2025-05-24]
STL à imprimer/Disque_moteur_propulsion.stl
5.00 x 123.3 x 124.0
