Emilien-Wolff/Pronto-Abysse/STL à imprimer/support esc.stl

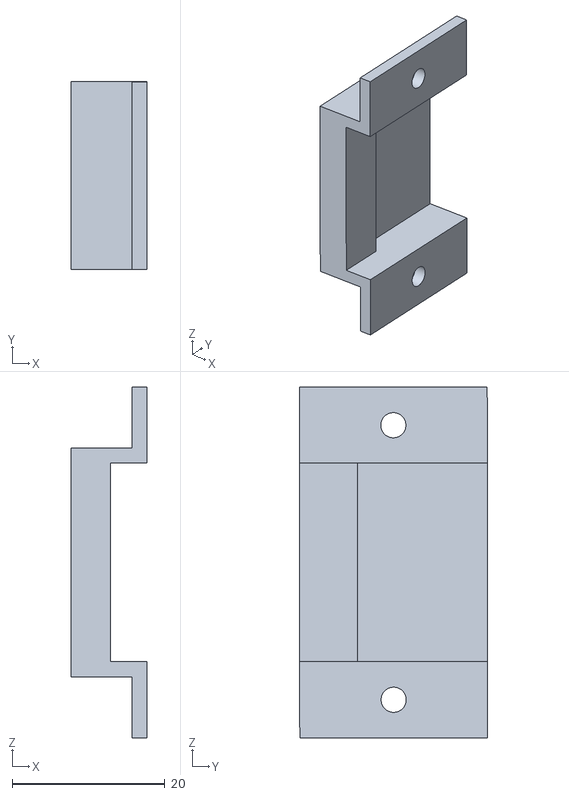
[picture p151: CAD file, 2025-05-24]
STL à imprimer/support esc.stl
10.0 x 24.7 x 46.0
