Emilien-Wolff/Pronto-Abysse/(list of files, cad)

Other CAD files:
STL à imprimer/disque_seringue_pointe_AV.stl
STL à imprimer/VoletHG 2.stl
STL à imprimer/Disque_base_seringueAR.stl
STL à imprimer/FixationServoDeriveV.stl
STL à imprimer/Disque moteur.step
STL à imprimer/Disque_base_seringue_AV.stl
