Emilien-Wolff/Pronto-Abysse/Plans 2D/accouplement arbre.pdf

# M3x0.5 6H

# COTE HELICE

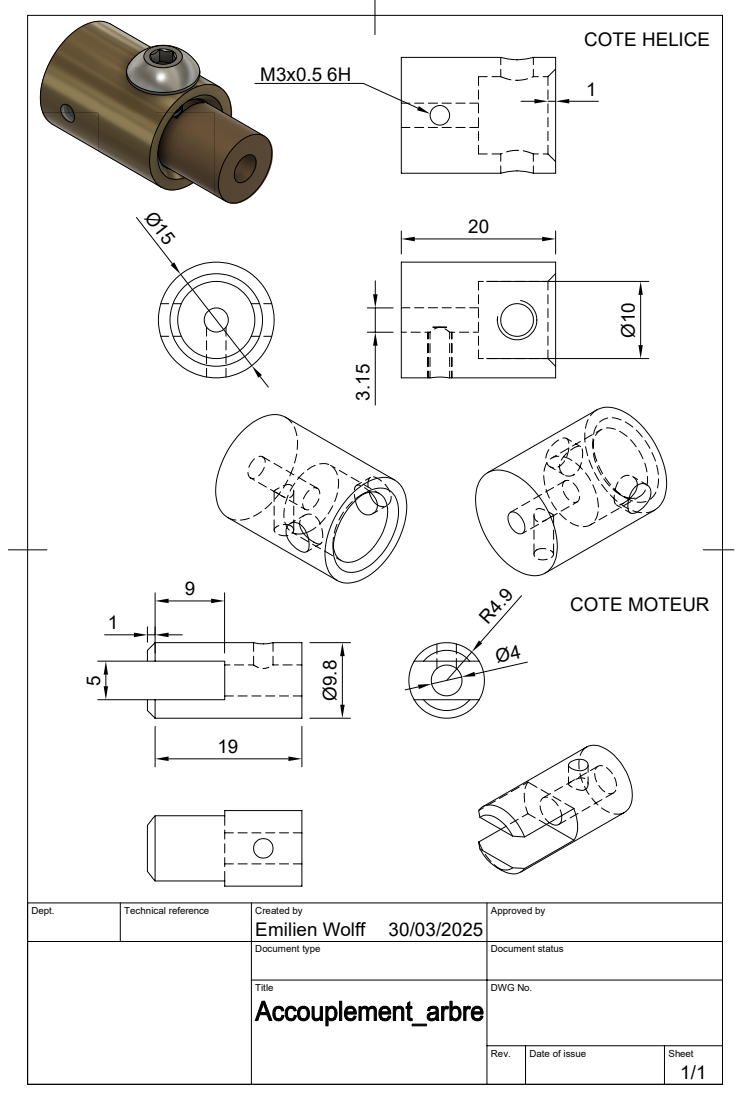
[picture p152: page 1]
Dept.; Technical reference; Created by; Approved by; Document type; Document status; Title; DWG No.; Rev.; Date of issue; Sheet; Emilien Wolff; COTE MOTEUR
