Emilien-Wolff/Pronto-Abysse/Plans 2D/Axe gouverne profondeur.pdf

# M3x0.5 6H

# M3x0.5 6H

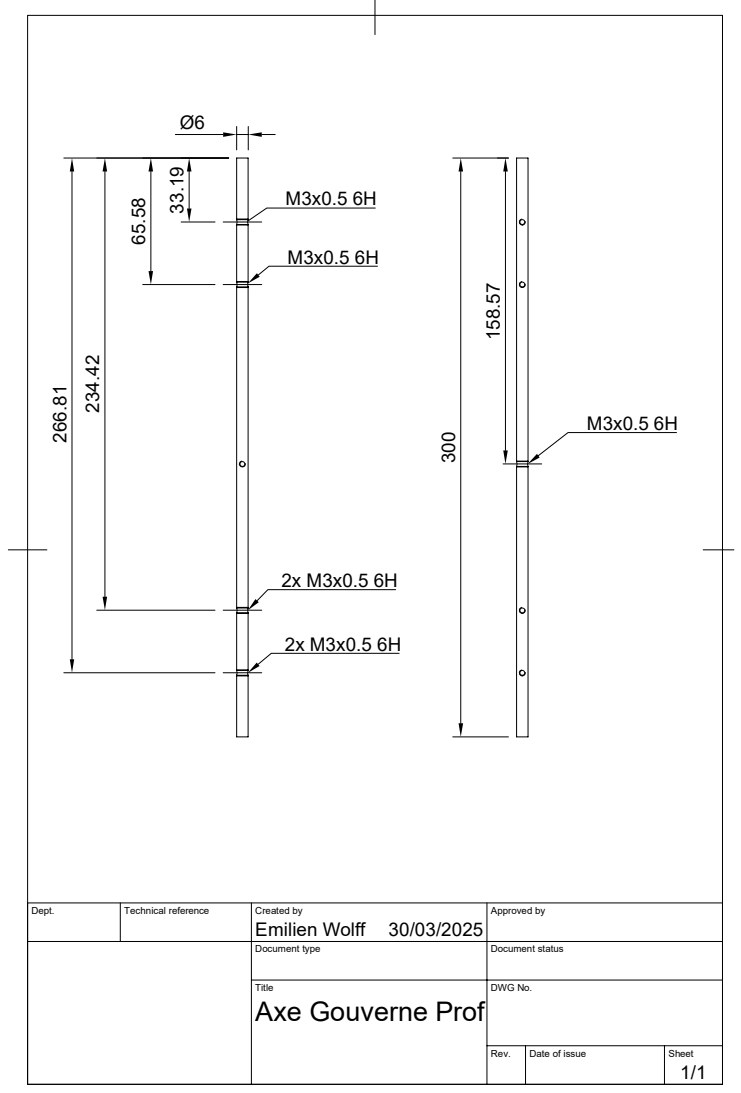
[picture p153: page 1]
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

Axe Gouverne Prof
