Emilien-Wolff/Pronto-Abysse/Codes/asservissement.h

void fill_ballast(bool front, float filling_percentage);

void sink(float delta_percentage);

float read_ballast(bool front);

void read_angles();

float ideal_percentage(int angle);

void correct_angle();
